nishinekoma/Tottori_Rover_science_27/サイエンス部門/派生component.md

# Fusion 360 操作メモ：既存コンポーネント2つを外部アセンブリファイルにまとめる

- 作業日：2026年11月9日
- 使用ソフト：Autodesk Fusion 360
- 目的：既存の設計ファイルに含まれる2つのコンポーネントを、新しい独立したアセンブリファイルにまとめる

---

## 1. 今回実現したかったこと

元となる設計ファイル：

`(nishimura)pusher-400mm-long_v2`

このファイルに含まれる次の2つのコンポーネントを、新しい外部ファイルにまとめる。

| 対象 | コンポーネント名 |
|---|---|
| 前側 | `Pusher_Front_400mm-v2` |
| 後側 | `Pusher_Rear_400mm-v2` |

### 最終的に目指すブラウザ構造

新規アセンブリファイルのルート直下に、2つのコンポーネントがそれぞれ独立して存在する状態。

```text
pusher-400-long_v2(component)
│
├─ Pusher_Front_400mm-v2:1
│  ├─ 原点
│  └─ ボディ
│
└─ Pusher_Rear_400mm-v2:1
   ├─ 原点
   └─ ボディ
```

**重要：** 元ファイル全体を親コンポーネントとして挿入するのではなく、対象の2コンポーネントを新しいアセンブリの直下に配置することが今回のポイント。

---

## 2. 前提条件

作業開始前に、次の状態を用意する。

- 元となるFusion 360の設計ファイルが存在する。
- その中に、まとめたい2つのコンポーネントが作成済みである。
- 対象のコンポーネントは、元ファイル内でそれぞれ独立している。
- Fusion 360のデータパネルから、対象ファイルを参照できる状態である。

今回の対象：

- `Pusher_Front_400mm-v2`
- `Pusher_Rear_400mm-v2`

### コンポーネントとボディの違い

- **ボディ：** 3D形状そのもの。形状を構成する単位。
- **コンポーネント：** ボディやスケッチ、原点などをまとめて管理する単位。アセンブリでは部品として扱う。

今回は、複数のボディを1つのコンポーネントとしてまとめる作業と、作成済みの2つのコンポーネントを別ファイルにまとめる作業は別の操作である。

---

## 3. 手順①：新しいファイルを作成する

1. Fusion 360のデータパネルを開く。
2. 新規作成から新しいデザインを作成する。
3. 「何を作成しますか？」という画面が表示される。
4. **「アセンブリ デザイン」**を選択する。
5. 単位系は今回と同じ `millimeter (mm), gram (g)` を選択する。
6. 「新規作成」を押す。

### 注意点

「パーツ デザイン」ではなく、必ず「アセンブリ デザイン」を選択する。

今回の目的は新しい形状を一から作ることではなく、既存のコンポーネントを組み合わせて管理することだからである。

---

## 4. 手順②：対象コンポーネントを外部ファイルとして用意する

元ファイル内の2つのコンポーネントを、新しいアセンブリから個別に参照できるようにする。

対象：

- `Pusher_Front_400mm-v2`
- `Pusher_Rear_400mm-v2`

今回の作業途中では、元ファイル側で「エクスポート」画面を開き、名前を `Pusher_Front_400mm-v2` に設定していることをスクリーンショットで確認できた。

エクスポート画面で確認できた設定：

| 項目 | 今回確認できた設定 |
|---|---|
| 名前 | `Pusher_Front_400mm-v2` |
| タイプ | Fusion ファイル（`.f3d`） |
| クラウド内のプロジェクトに書き出し | チェックなし |
| ローカルコンピュータに書き出し | チェックあり |
| 保存先 | `C:/Users/nishi/Downloads` |

ただし、会話記録とスクリーンショットだけでは、Rear側のエクスポート操作の全設定や、その後にクラウド上へ登録された経緯までは確認できない。

そのため、**個別コンポーネントを外部ファイル化する際の細かなエクスポート手順は、今回の記録だけでは完全には再現できない。**

---

## 5. 手順③：新しいアセンブリにコンポーネントを挿入する

1. 新しく作成したアセンブリファイルを開く。
2. 上部の「アセンブリ」タブを選択する。
3. 「挿入」メニューを開く。
4. 「コンポーネントを挿入」を選択する。
5. プロジェクト内のファイル一覧が表示される。
6. 対象となるコンポーネントファイルを選択する。
7. 「挿入」を押す。

### 今回の重要な注意点

最初は元ファイル全体である、

`(nishimura)pusher-400mm-long_v2`

を選択して挿入した。

その結果、新しいアセンブリの中に元ファイル全体が親コンポーネントとして配置され、その下に対象コンポーネントが入る構造になった。

```text
新規アセンブリ
│
└─ (nishimura)pusher-400mm-long_v2
   │
   ├─ Pusher_Front_400mm-v2
   ├─ Pusher_Rear_400mm-v2
   └─ その他のコンポーネントなど
```

これは今回目指していた構造とは異なる。

**元ファイル全体ではなく、対象のコンポーネントを個別に挿入すること。**

---

## 6. 手順④：最終状態を確認する

最終的に、新しいアセンブリファイルのブラウザには、次の2つが別々に表示された。

```text
pusher-400-long_v2(component)
│
├─ Pusher_Front_400mm-v2:1
└─ Pusher_Rear_400mm-v2:1
```

画面上では2つの部品がそれぞれ別のコンポーネントとして表示され、選択すると個別にハイライトされることも確認できた。

これにより、今回の目的である「2つのコンポーネントを1つの外部アセンブリファイルにまとめる」状態になった。

---

## 7. `:1` の意味

ブラウザに表示される、

- `Pusher_Front_400mm-v2:1`
- `Pusher_Rear_400mm-v2:1`

の末尾の `:1` は、コンポーネントのインスタンス番号を示す。

インスタンスとは、アセンブリ内に配置されたコンポーネントの実体（配置された部品）を指す。

同じコンポーネントを複数回配置すると、例えば次のように番号が付くことがある。

```text
Motor:1
Motor:2
Motor:3
```

したがって、`:1` はファイル名やバージョン番号ではない。

---

## 8. 今回の作業で覚えておくこと

- 新しいファイルを作るときは「アセンブリ デザイン」を選ぶ。
- 元ファイル全体を挿入すると、元ファイルが親階層になる。
- 今回のように対象部品だけをまとめたい場合は、対象コンポーネントを個別に扱う。
- アセンブリのブラウザで、2つがルート直下に表示されているか確認する。
- `:1` はインスタンス番号である。
- 元ファイルと新しいアセンブリファイルは別のファイルとして管理する。

---

## 9. 次回のための確認チェックリスト

- [ ] 元ファイルに対象コンポーネントが存在する。
- [ ] 対象コンポーネントを個別に外部ファイル化する。
- [ ] 新しいファイルを「アセンブリ デザイン」で作成する。
- [ ] 単位系を確認する（今回：mm、g）。
- [ ] 「コンポーネントを挿入」から対象部品を個別に挿入する。
- [ ] 元ファイル全体を誤って挿入していないか確認する。
- [ ] ブラウザのルート直下に対象コンポーネントが並んでいることを確認する。
- [ ] ファイルを保存する。

---

## 10. 記録上の未確認事項

今回の会話記録から、最終的なファイル構造と画面上の成功状態は確認できる。

一方で、個別コンポーネントをクラウド上のプロジェクトに登録するまでの全操作や、Rear側のエクスポート設定は記録が不足している。

そのため、次回この作業を完全に再現する場合は、**元ファイルから個別コンポーネントを外部ファイル化する工程**について、操作画面を確認しながら進める必要がある。
