nishinekoma/Tottori_Rover_science_27/サイエンス部門/common/sience_tasks.png

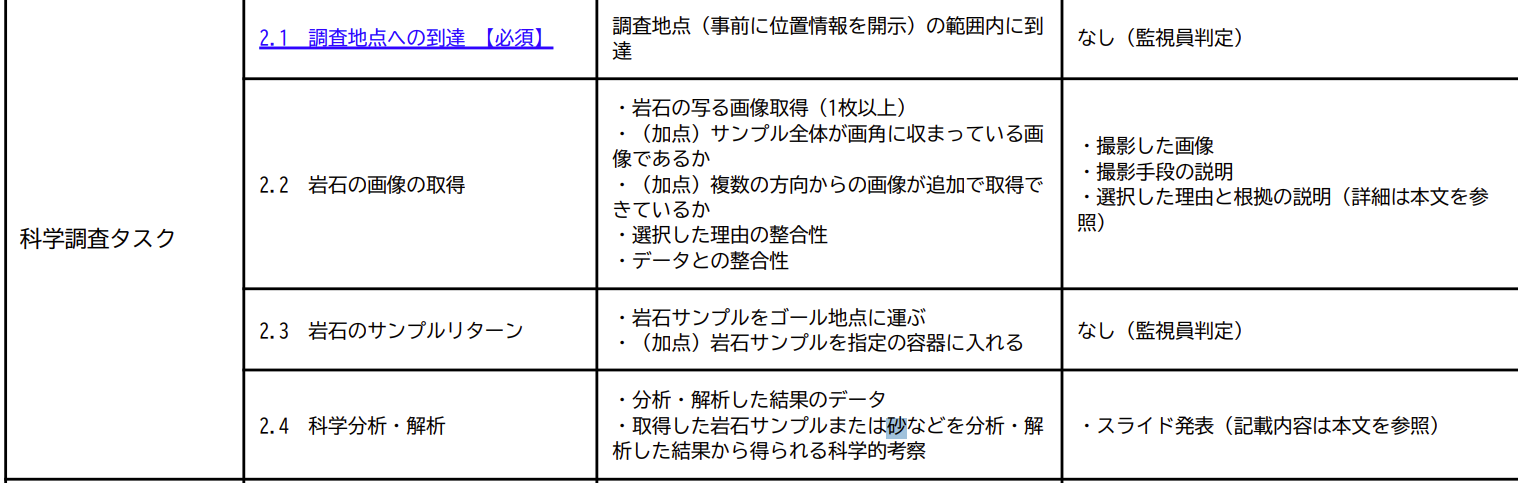
サイエンス部門/common/sience_tasks.png
