nishinekoma/Tottori_Rover_science_27/サイエンス部門/common/配線図/3.jpg

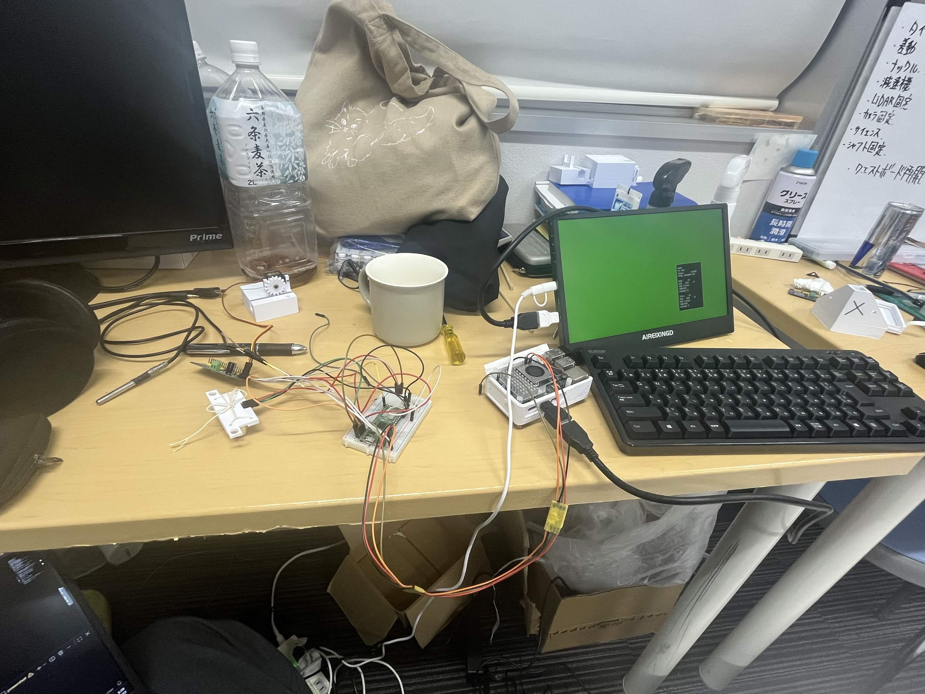
サイエンス部門/common/配線図/3.jpg
