nishinekoma/Tottori_Rover_science_27/サイエンス部門/common/配線図/結合.png

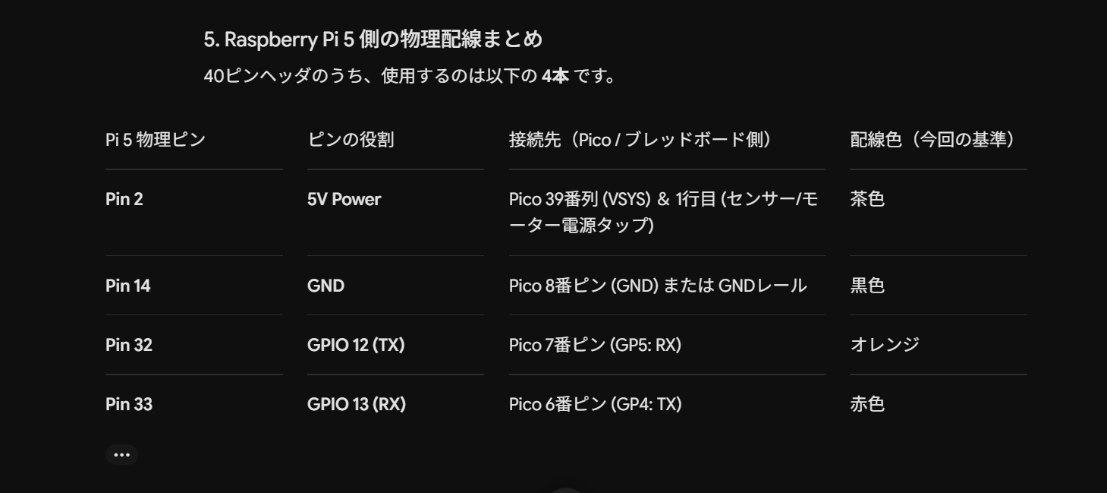
サイエンス部門/common/配線図/結合.png
