nishinekoma/Tottori_Rover_science_27/サイエンス部門/common/配線図/ultrasonic_sensor.step

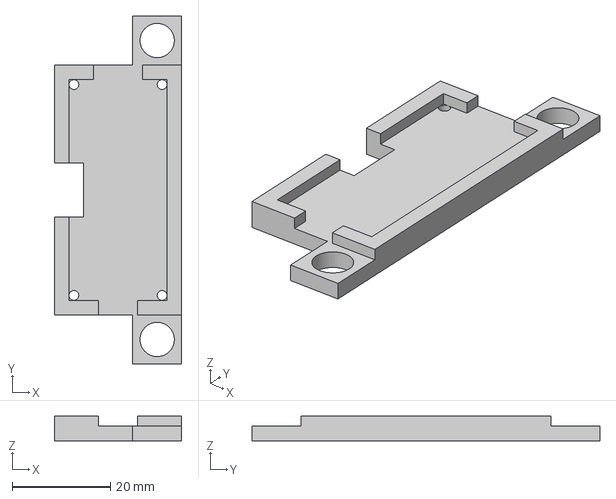
[picture p7: CAD file, 2026-10-21]
サイエンス部門/common/配線図/ultrasonic_sensor.step
26.0 x 71.0 x 5.00 mm
