nishinekoma/Tottori_Rover_science_27/サイエンス部門/printer-data/mesh_data/motor-bracket-mini-version.stl

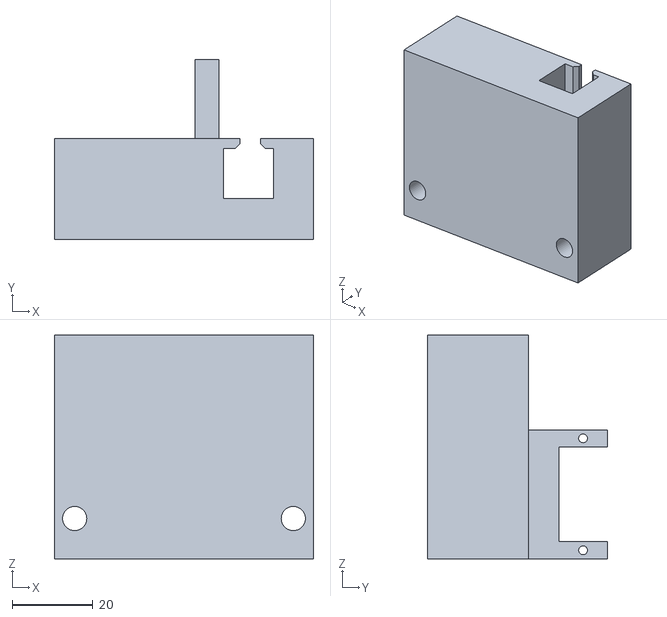
[picture p8: CAD file, 2026-10-21]
サイエンス部門/printer-data/mesh_data/motor-bracket-mini-version.stl
64.2 x 44.5 x 55.5
