nishinekoma/Tottori_Rover_science_27/サイエンス部門/printer-data/step_data/pusher-400mm-long.step

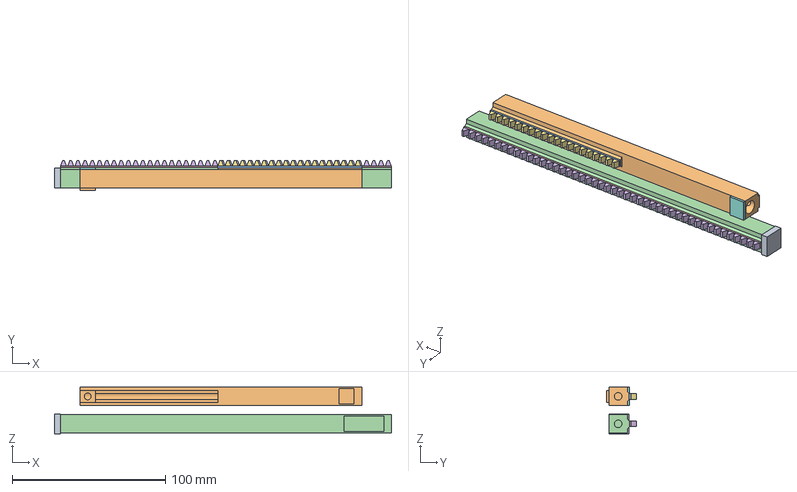
[picture p9: CAD file, 2026-10-21]
サイエンス部門/printer-data/step_data/pusher-400mm-long.step
220.0 x 19.4 x 30.4 mm
