nishinekoma/Tottori_Rover_science_27/サイエンス部門/printer-data/mesh_data/pusher-400mm-long_v2.stl

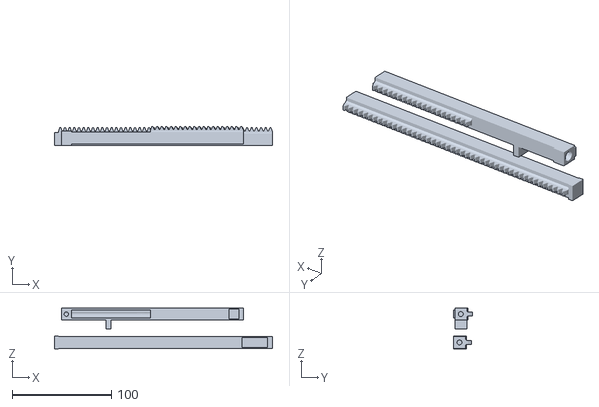
[picture p10: CAD file, 2026-10-21]
サイエンス部門/printer-data/mesh_data/pusher-400mm-long_v2.stl
220.0 x 19.4 x 41.1
