nishinekoma/Tottori_Rover_science_27/サイエンス部門/printer-data/step_data/SpurGear.step

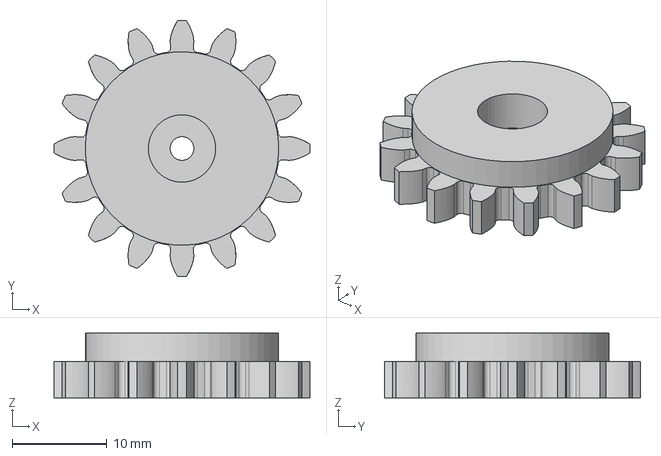
[picture p11: CAD file, 2026-10-21]
サイエンス部門/printer-data/step_data/SpurGear.step
27.0 x 27.0 x 6.81 mm
