nishinekoma/Tottori_Rover_science_27/サイエンス部門/printer-data/step_data/motor-bracket-mini-version.step

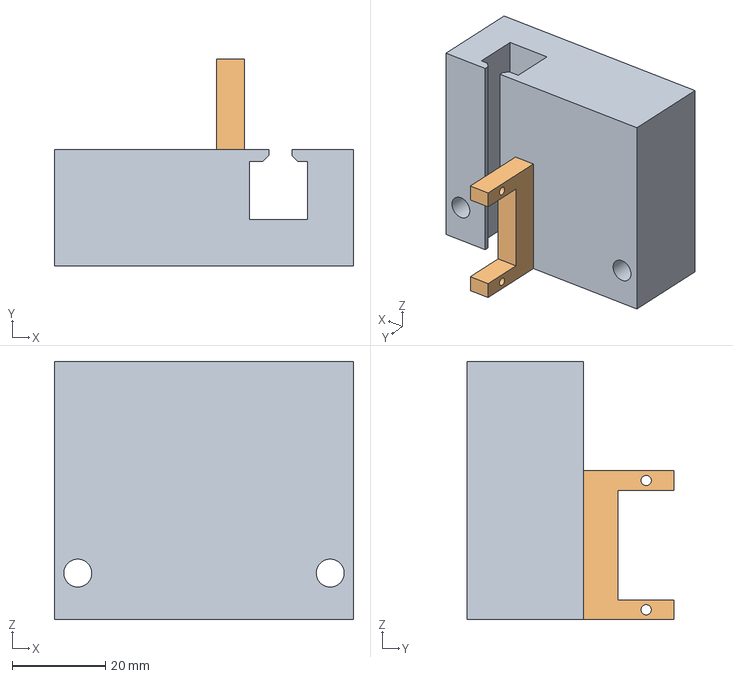
[picture p12: CAD file, 2026-10-21]
サイエンス部門/printer-data/step_data/motor-bracket-mini-version.step
64.2 x 44.5 x 55.5 mm
