nishinekoma/Tottori_Rover_science_27/サイエンス部門/printer-data/mesh_data/ultrasonic_sensor2.stl

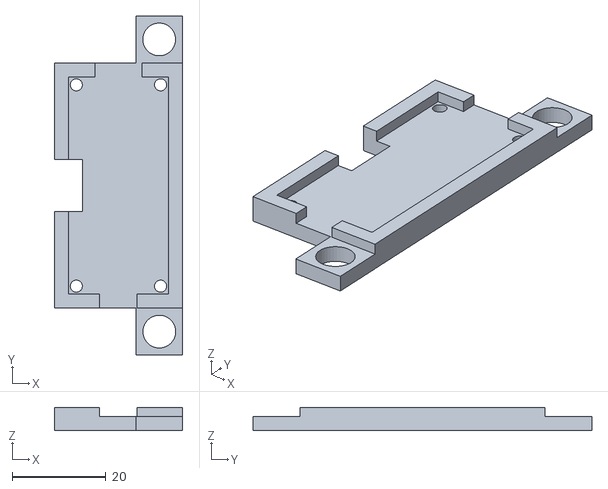
[picture p13: CAD file, 2026-10-21]
サイエンス部門/printer-data/mesh_data/ultrasonic_sensor2.stl
27.4 x 72.4 x 5.00
