nishinekoma/Tottori_Rover_science_27/(list of files, cad)

Other CAD files:
サイエンス部門/printer-data/mesh_data/pusher-400mm-long.stl
サイエンス部門/printer-data/mesh_data/SpurGear.stl
サイエンス部門/printer-data/f3d_data/SpurGear.f3d
サイエンス部門/printer-data/f3d_data/motor-bracket-mini-version.f3d
サイエンス部門/printer-data/f3d_data/pusher-400mm-long.f3d
サイエンス部門/printer-data/ビャンさんデータ/motor-bracket-mini-version.f3d
サイエンス部門/printer-data/ビャンさんデータ/pinion-gear-mini-version.f3d
サイエンス部門/printer-data/ビャンさんデータ/pusher-150mm-long.f3d
